LonghornRacingElectric/Charging_Board/Footprints/LIB_G6B-1114P-US-DC24/G6B-1114P-US-DC24/3D/G6B-1114P-US-DC24.stp

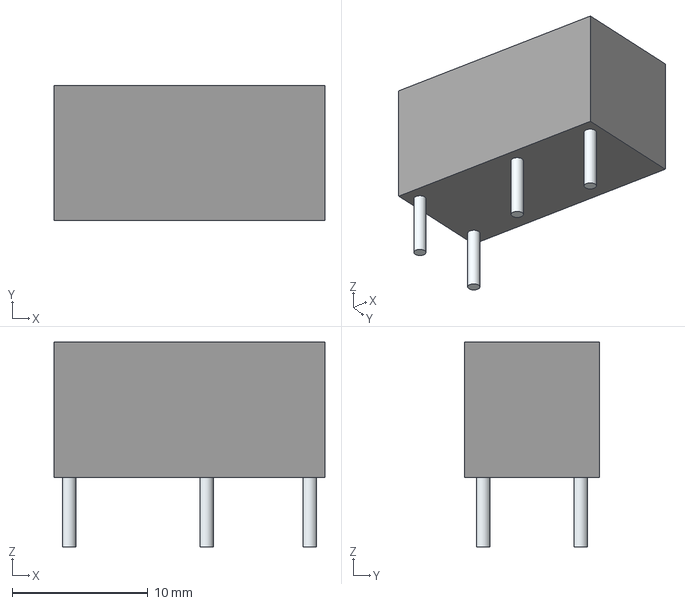
[picture p1: CAD file, 2023-02-12]
Footprints/LIB_G6B-1114P-US-DC24/G6B-1114P-US-DC24/3D/G6B-1114P-US-DC24.stp
20.0 x 10.0 x 15.1 mm
Leads x 4
