LonghornRacingElectric/Charging_Board/Footprints/LIB_IPD650P06NMATMA1/IPD650P06NMATMA1/3D/IPD650P06NMATMA1.stp

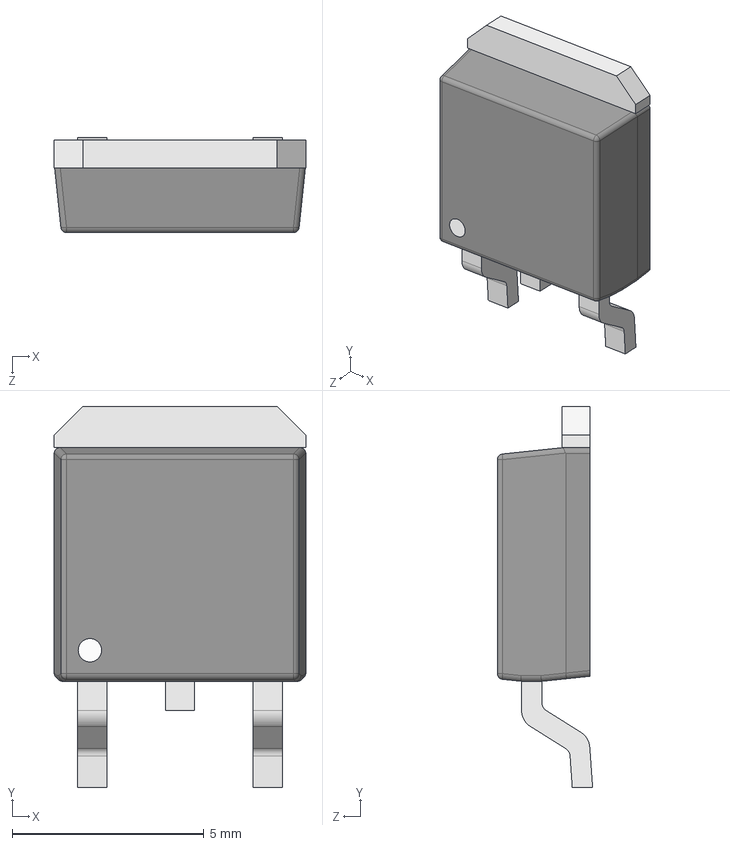
[picture p2: CAD file, 2023-02-13]
Footprints/LIB_IPD650P06NMATMA1/IPD650P06NMATMA1/3D/IPD650P06NMATMA1.stp
6.57 x 9.94 x 2.49 mm
