LonghornRacingElectric/Charging_Board/Footprints/LIB_RBQ10RSM10BTL1/RBQ10RSM10BTL1/3D/RBQ10RSM10BTL1.stp

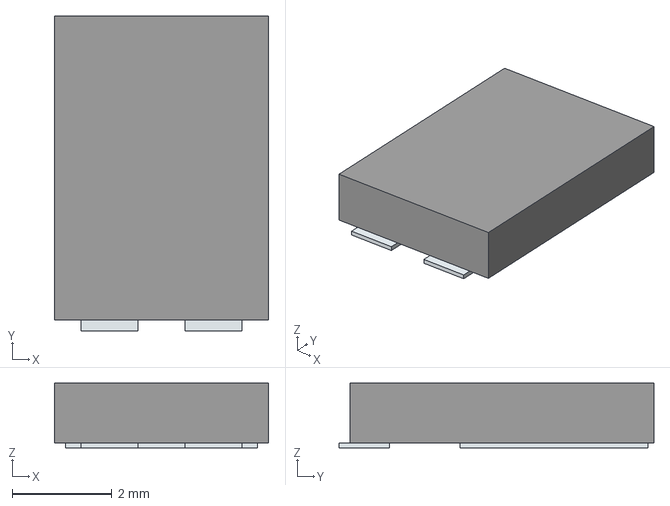
[picture p3: CAD file, 2023-03-05]
Footprints/LIB_RBQ10RSM10BTL1/RBQ10RSM10BTL1/3D/RBQ10RSM10BTL1.stp
4.30 x 6.32 x 1.30 mm
Pins
