LonghornRacingElectric/Charging_Board/Footprints/LIB_355015KFT/355015KFT/3D/355015KFT.stp

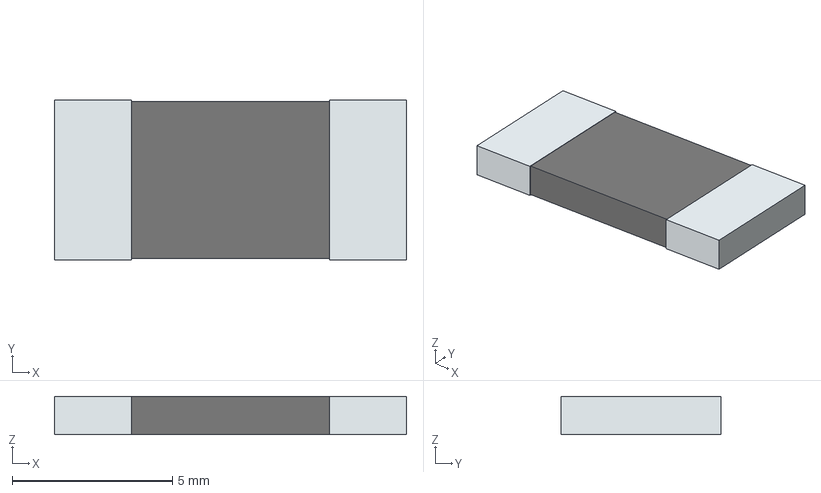
[picture p4: CAD file, 2023-03-05]
Footprints/LIB_355015KFT/355015KFT/3D/355015KFT.stp
11.0 x 5.00 x 1.20 mm
term1
term2
