LonghornRacingElectric/Charging_Board/(list of files, cad)

Other CAD files:
Footprints/LIB_355015KFT/355015KFT/Allegro/resc11050x120n.psm
Footprints/LIB_355015KFT/355015KFT/DEHDL/355015kft/chips/chips.prt
Footprints/LIB_G6B-1114P-US-DC24/G6B-1114P-US-DC24/Allegro/g6b1114pusdc24.psm
Footprints/LIB_G6B-1114P-US-DC24/G6B-1114P-US-DC24/DEHDL/g6b_1114p_us_dc24/chips/chips.prt
Footprints/LIB_IPD650P06NMATMA1/IPD650P06NMATMA1/Allegro/bts3035tfatma1.psm
Footprints/LIB_IPD650P06NMATMA1/IPD650P06NMATMA1/DEHDL/ipd650p06nmatma1/chips/chips.prt
Footprints/LIB_RBQ10RSM10BTL1/RBQ10RSM10BTL1/Allegro/rbq10rsm10btl1.psm
Footprints/LIB_RBQ10RSM10BTL1/RBQ10RSM10BTL1/DEHDL/rbq10rsm10btl1/chips/chips.prt
