LonghornRacingElectric/Charging_Board/(list of files, drawings)

Other design files:
Footprints/LIB_355015KFT/355015KFT/Altium/355015KFT.SchLib
Footprints/LIB_355015KFT/355015KFT/Altium/RESC11050X120N.PcbLib
Footprints/LIB_IPD650P06NMATMA1/IPD650P06NMATMA1/Altium/BTS3035TFATMA1.PcbLib
Footprints/LIB_IPD650P06NMATMA1/IPD650P06NMATMA1/Altium/IPD650P06NMATMA1.SchLib
Footprints/LIB_RBQ10RSM10BTL1/RBQ10RSM10BTL1/Altium/RBQ10RSM10BTL1.PcbLib
Footprints/LIB_RBQ10RSM10BTL1/RBQ10RSM10BTL1/Altium/RBQ10RSM10BTL1.SchLib
