LonghornRacingElectric/Charging_Board/HV_Charger.kicad_pcb

## KiCad design HV_Charger.kicad_pcb (2023-03-05)

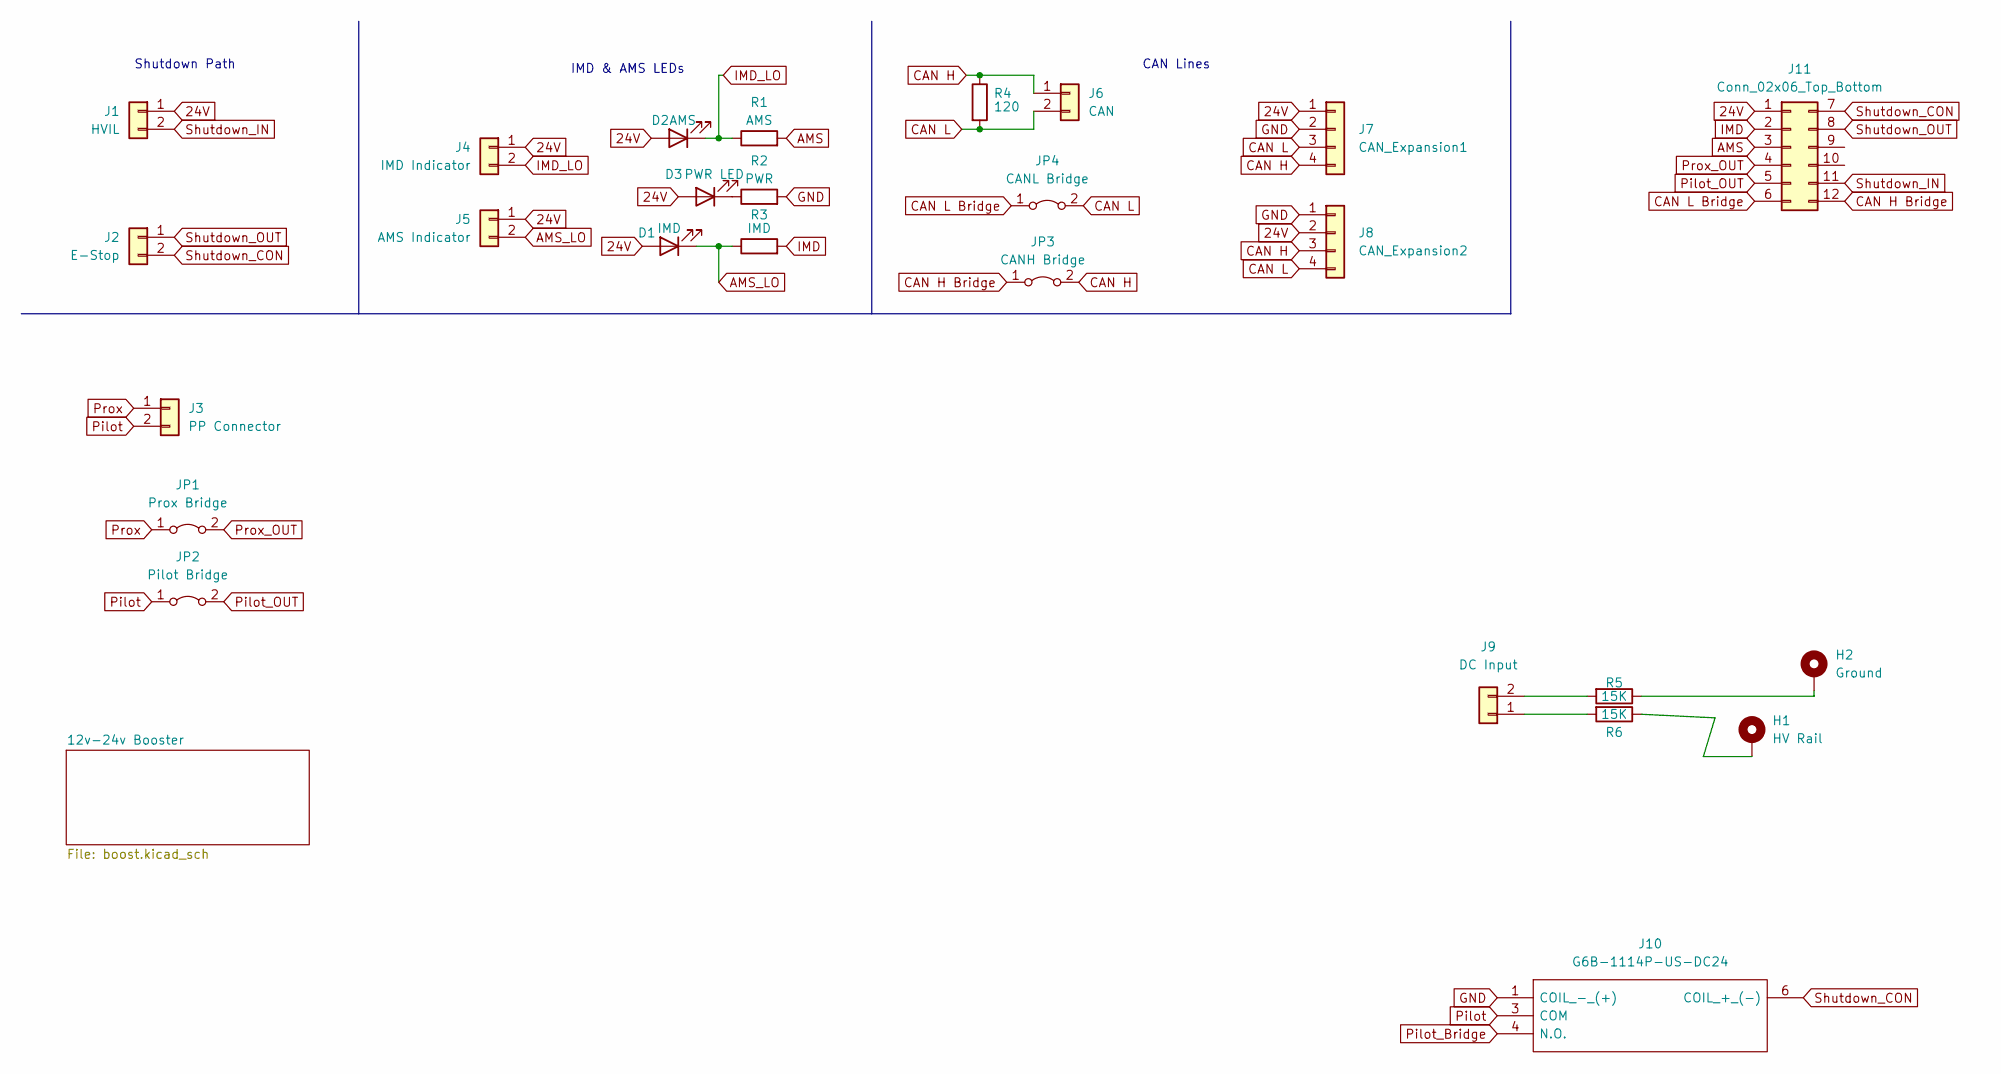
[picture p5: schematic HV_Charger.kicad_sch]

Parts:
D1: IMD; LED_0603_1608Metric
D2: AMS; LED_0603_1608Metric
D3: PWR LED; LED_0603_1608Metric
H1: HV Rail; Banana_Jack
H2: Ground; Banana_Jack
J1: HVIL; Molex_Micro-Fit_3.0_43045-0212_2x01_P3.00mm_Vertical
J2: E-Stop; Molex_Micro-Fit_3.0_43045-0212_2x01_P3.00mm_Vertical
J3: PP Connector; Molex_Micro-Fit_3.0_43045-0212_2x01_P3.00mm_Vertical
J4: IMD Indicator; Molex_Micro-Fit_3.0_43045-0212_2x01_P3.00mm_Vertical
J5: AMS Indicator; Molex_Micro-Fit_3.0_43045-0212_2x01_P3.00mm_Vertical
J6: CAN; Molex_Micro-Fit_3.0_43045-0212_2x01_P3.00mm_Vertical
J7: CAN_Expansion1; Molex_Micro-Fit_3.0_43045-0412_2x02_P3.00mm_Vertical
J8: CAN_Expansion2; Molex_Micro-Fit_3.0_43045-0412_2x02_P3.00mm_Vertical
J9: DC Input; Molex_Micro-Fit_3.0_43045-0212_2x01_P3.00mm_Vertical
J10: G6B-1114P-US-DC24; G6B1114PUSDC24; Mouser Part Number 653-G6B-1114P-DC24
J11: Conn_02x06_Top_Bottom; Molex_Micro-Fit_3.0_43045-1212_2x06_P3.00mm_Vertical
JP1: Prox Bridge; SolderJumper-2_P1.3mm_Open_Pad1.0x1.5mm
JP2: Pilot Bridge; SolderJumper-2_P1.3mm_Open_Pad1.0x1.5mm
JP3: CANH Bridge; SolderJumper-2_P1.3mm_Open_Pad1.0x1.5mm
JP4: CANL Bridge; SolderJumper-2_P1.3mm_Open_Pad1.0x1.5mm
R1: AMS; R_0603_1608Metric
R2: PWR; R_0603_1608Metric
R3: IMD; R_0603_1608Metric
R4: 120; R_0603_1608Metric
R5, R6: 15K; RESC11050X120N

Connections:
24V: D1.2 (A), D2.2 (A), D3.2 (A), J1.1, J4.1, J5.1, J7.1, J8.2, J11.1; also elsewhere on the board
AMS: J11.3, R1.2
AMS_LO: D1.1 (K), J5.2, R3.1
CAN H: J6.1, J7.4, J8.3, JP3.2 (B), R4.1
CAN H Bridge: J11.12, JP3.1 (A)
CAN L: J6.2, J7.3, J8.4, JP4.2 (B), R4.2
CAN L Bridge: J11.6, JP4.1 (A)
GND: J7.2, J8.1, J10.1 (COIL_-_(+)), R2.2; also elsewhere on the board
IMD: J11.2, R3.2
IMD_LO: D2.1 (K), J4.2, R1.1
unnamed: D3.1 (K), R2.1
unnamed: H1.1, R6.1
unnamed: H2.1, R5.1
unnamed: J9.1, R6.2
unnamed: J9.2, R5.2
Pilot: J3.2, J10.3 (COM), JP2.1 (A)
Pilot_OUT: J11.5, JP2.2 (B)
Prox: J3.1, JP1.1 (A)
Prox_OUT: J11.4, JP1.2 (B)
Shutdown_CON: J2.2, J10.6 (COIL_+_(-)), J11.7
Shutdown_IN: J1.2, J11.11
Shutdown_OUT: J2.1, J11.8

Notes on the sheet:
CAN Lines
IMD & AMS LEDs
Shutdown Path

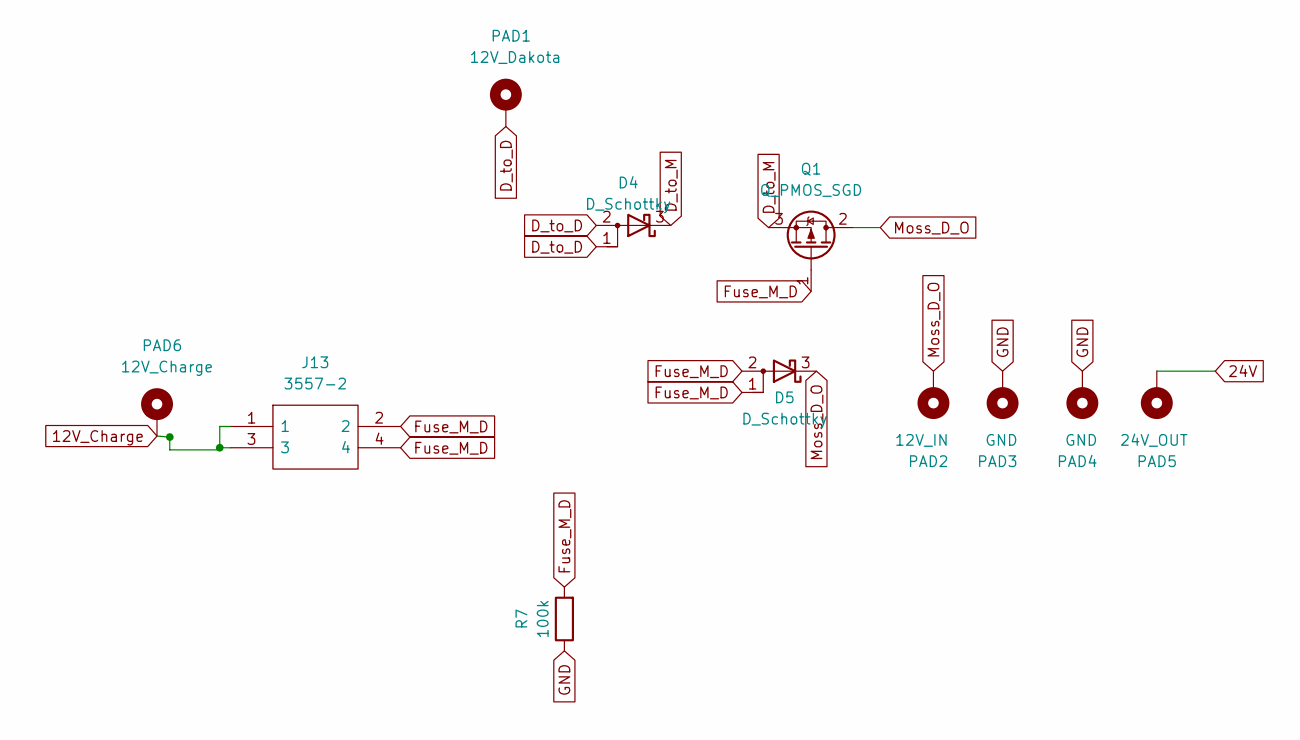
[picture p6: schematic boost.kicad_sch]

Parts:
D4, D5: D_Schottky; RBQ10RSM10BTL1
J13: 3557-2; Manufacturer_Part_Number 3557-2; Mouser Part Number 534-3557-2
PAD1: 12V_Dakota; TestPoint_Pad_4.0x4.0mm
PAD2: 12V_IN; TestPoint_Pad_4.0x4.0mm
PAD3, PAD4: GND; TestPoint_Pad_4.0x4.0mm
PAD5: 24V_OUT; TestPoint_Pad_4.0x4.0mm
PAD6: 12V_Charge; TestPoint_Pad_4.0x4.0mm
Q1: Q_PMOS_SGD; BTS3035TFATMA1
R7: 100k; R_0603_1608Metric

Connections:
12V_Charge: J13.1, J13.3, PAD6.1
24V: PAD5.1; also elsewhere on the board
D_to_D: D4.1 (A), D4.2 (A), PAD1.1
D_to_M: D4.3 (K), Q1.3 (S)
Fuse_M_D: D5.1 (A), D5.2 (A), J13.2, J13.4, Q1.1 (G), R7.2
GND: PAD3.1, PAD4.1, R7.1; also elsewhere on the board
Moss_D_O: D5.3 (K), PAD2.1, Q1.2 (D)

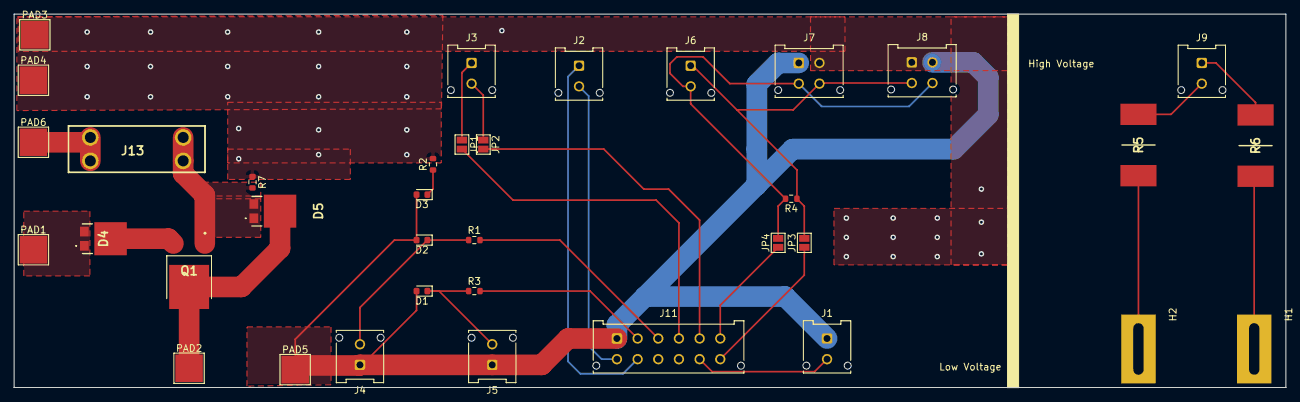
[picture p7: board HV_Charger.kicad_pcb from above]

Board: 2 copper layers, 184.6 x 54.2 mm, 36 parts (0 on the bottom side), 27 nets.
