LonghornRacingElectric/Charging_Board/(commit log)

2023-02-12 First Comms
    [HV_Charger.kicad_pcb, HV_Charger.kicad_sch]
2023-02-12 Foot added
    [EDI2CAP.CFG, G6B-1114P-US-DC24.stp, chips.prt, g6b1114pusdc24.psm]
2023-02-13 footprint added for pmos
    [BTS3035TFATMA1.PcbLib, EDI2CAP.CFG, IPD650P06NMATMA1.SchLib, IPD650P06NMATMA1.stp, bts3035tfatma1.psm, chips.prt]
2023-02-19 Fixed Rylan issues, pls switch diodes on pmos
    [HV_Charger.kicad_sch, boost.kicad_sch]
2023-02-19 Fixed Rylan issues, pls change diode direction on pmos, Also Arjun pushed wrong format and messed up my end >:(
    [HV_Charger.kicad_pcb, HV_Charger.kicad_sch, boost.kicad_sch]
2023-02-19 Finished Schematic?
    [HV_Charger.kicad_sch, boost.kicad_sch]
2023-03-05 did basic layout
    [HV_Charger.kicad_pcb, HV_Charger.kicad_sch, boost.kicad_sch]
2023-03-05 more stuff done
    [HV_Charger.kicad_pcb, HV_Charger.kicad_sch, boost.kicad_sch]
2023-03-05 Added more footprints and did layout, banana jack left to do:
    [355015KFT.SchLib, 355015KFT.stp, EDI2CAP.CFG, HV_Charger.kicad_pcb, RBQ10RSM10BTL1.PcbLib, RBQ10RSM10BTL1.SchLib, RBQ10RSM10BTL1.stp, RESC11050X120N.PcbLib]
2023-03-05 Made corrections
    [HV_Charger.kicad_pcb, HV_Charger.kicad_sch, boost.kicad_sch]
